NextGen-Environmental-Sensor-Lab/RS232-2-Sheets-ESP/images/B156B095404276F9.jpg

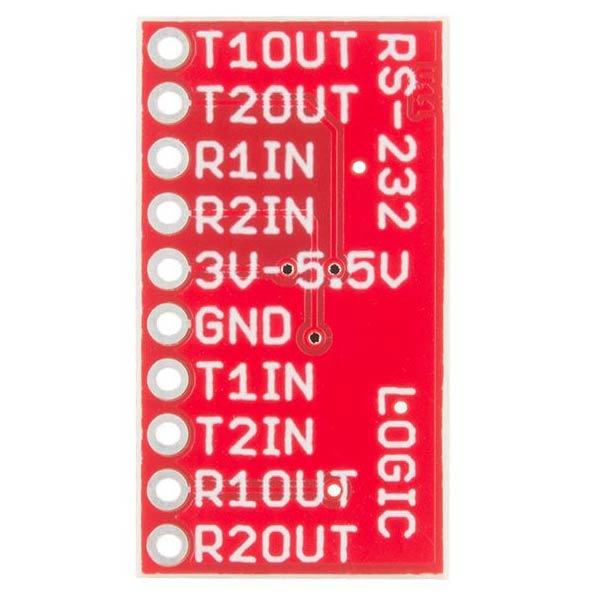
images/B156B095404276F9.jpg
