NextGen-Environmental-Sensor-Lab/RS232-2-Sheets-ESP/images/B156B095404276FB.jpg

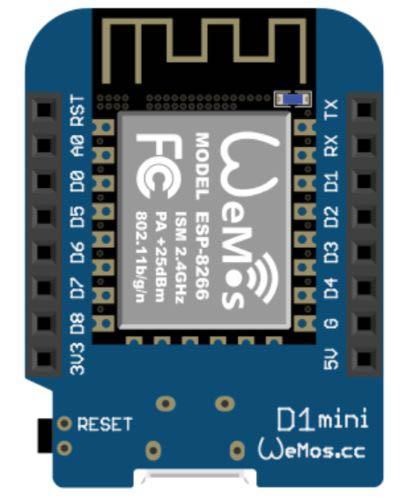
images/B156B095404276FB.jpg
