NextGen-Environmental-Sensor-Lab/RS232-2-Sheets-ESP/images/RS232-2-Sheets-ESP.pdf

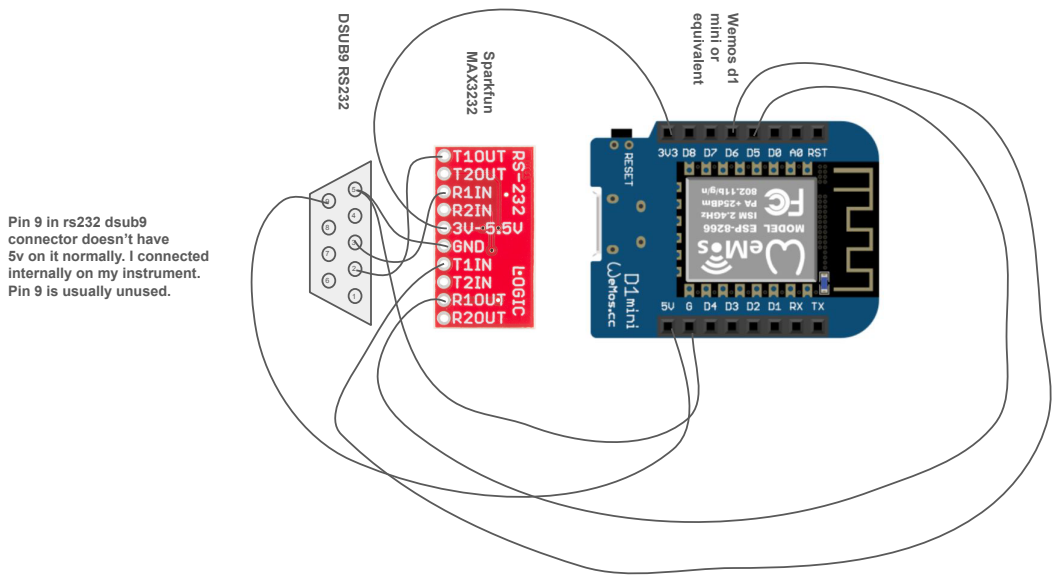
[picture p5: page 1]
y. I connected; DSUB9 RS232; MAX3232; Sparkfun; Wemos d1; equivalent; mini or

Pin 9 in rs232 dsub9
connector doesn’t have
5v on it normall
internally on my instrument.
Pin 9 is usually unused.
