NextGen-Environmental-Sensor-Lab/RS232-2-Sheets-ESP/images/rs232-2-sheets-esp_schematic.pdf

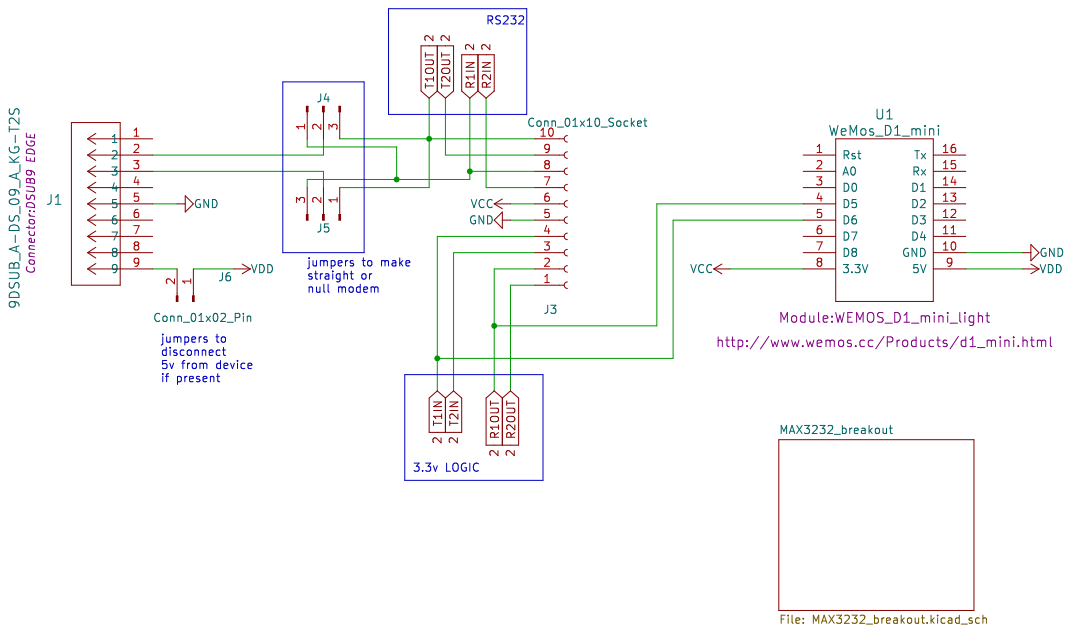
[picture p6: page 1]

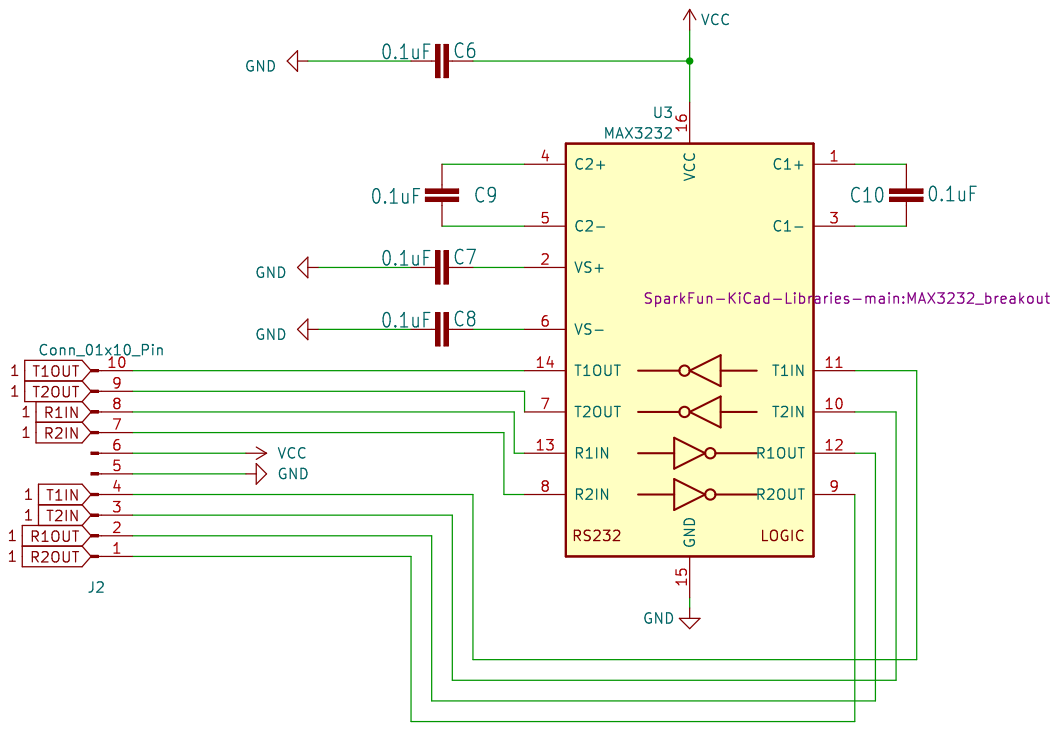
[picture p7: page 2]
