NextGen-Environmental-Sensor-Lab/RS232-2-Sheets-ESP/(threads)

Thread 1 (2023-11-30):

reboot instead of sleep

rictolcrow, 2023-11-30:
https://github.com/NextGen-Environmental-Sensor-Lab/RS232-2-Sheets-ESP/blob/38717406f1048a6996b73090cad4d480da3b30bc/RS232-2-Sheets-ESP.ino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

rictolcrow, 2024-01-03:
instead of ESP.deepSleep() use ESP.restart().

Possibly keeping a timer so that if it does it again wait for 20 mins or so because the WiFi is prob down.

rictolcrow, 2024-07-09:
done

Closed 2024-07-09.

Thread 4 (2024-05-02):

add watchdog timer

rictolcrow, 2024-05-02:
device seemed to hang once. A reset put it right. Watchdog timer needed
