NextGen-Environmental-Sensor-Lab/RS232-2-Sheets-ESP/(commit log)

2023-11-15 modded pdf schematic
2024-07-09 code stopped working and fixed
    fixed by checking that still connected to host (google.com) and if not reconnect. One error was using static vars in main loop
    [Provisioning.cpp, RS232-2-Sheets-ESP.ino]
2025-02-07 Update of Main Code (Fixes data upload rate for 5 min)
    [RS232-2-Sheets-ESP.ino]
